pierreblavy2/esp8266-relay/(commit log)

2021-01-01 V 1.0
    Current version, actually works
2021-09-28 Update State.hpp
    BUGFIX setting the password set the ssid
    [State.hpp]
2021-09-28 Update esp-relay.ino
    BUGFIX : set default wifi after make_default
    [esp-relay.ino]
